grandinquisitor/chip_tunes_badge/hardware/schematic.pdf

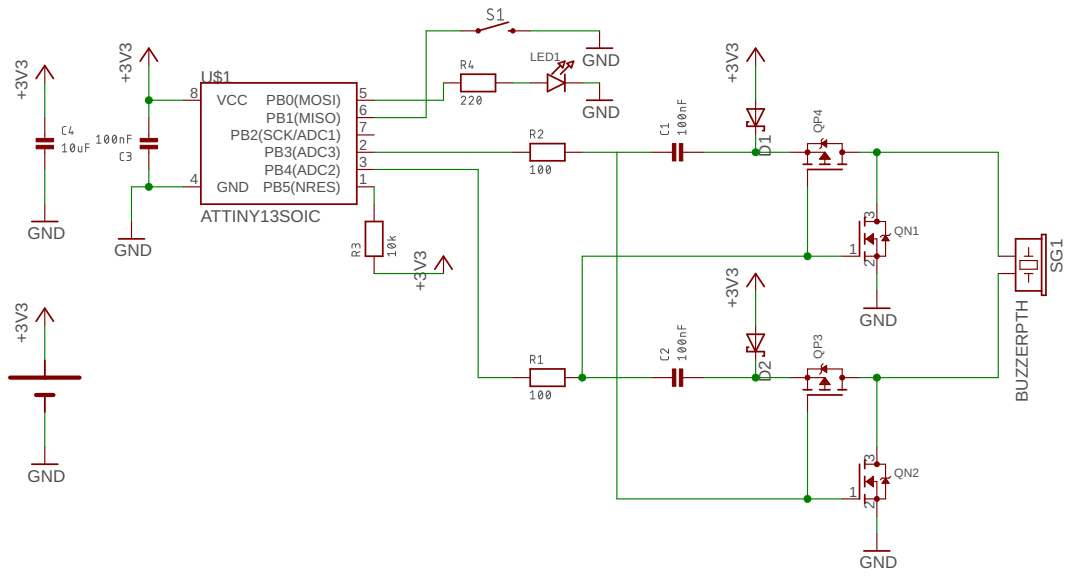
[picture p1: page 1]
