grandinquisitor/chip_tunes_badge/hardware/schematic.sch

## EAGLE design hardware/schematic.sch (2019-09-23)

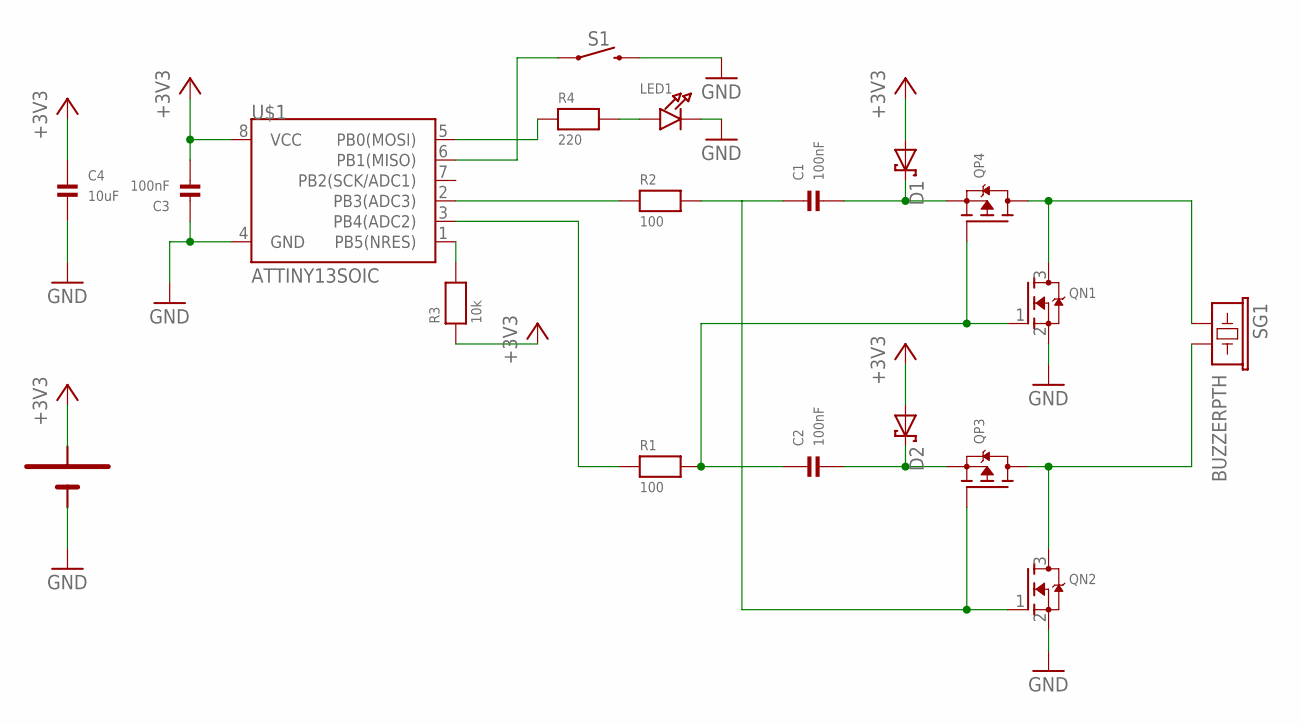
[picture p2: schematic schematic.sch]

Parts:
C1, C2, C3: 100nF; 0805
C4: 10uF; 0805
D1: SCOTTKY; SOD123F
D2: BAT20J; SOD123F
LED1: LED0805_NOOUTLINE; CHIPLED_0805_NOOUTLINE
QN1, QN2: MOSFET-NWIDE; SOT23-WIDE
QP3, QP4: MOSFET-PWIDE; SOT23-WIDE
R1, R2: 100; 0805
R3: 10k; 0805
R4: 220; 0805
S1: MOMENTARY-SWITCH-SPST-SMD-5.2MM; TACTILE_SWITCH_SMD_5.2MM
SG1: BUZZERPTH; BUZZER-12MM
U$1: ATTINY13SOIC; SO08
U$2: CR2032; COIN

Connections:
+3V3: C3.2, C4.1, D1.2 (A), D2.2 (A), R3.1, U$1.8 (VCC), U$2.+
GND: C3.1, C4.2, LED1.C, QN1.2 (S), QN2.2 (S), S1.3 (2), U$1.4 (GND), U$2.-
unnamed: R2.1, U$1.2 (PB3(ADC3))
unnamed: R1.1, U$1.3 (PB4(ADC2))
unnamed: C1.1, QN2.1 (G), QP3.1 (G), R2.2
unnamed: C2.1, QN1.1 (G), QP4.1 (G), R1.2
unnamed: C1.2, D1.1 (K), QP4.2 (S)
unnamed: QN1.3 (D), QP4.3 (D), SG1.+ (1)
unnamed: QN2.3 (D), QP3.3 (D), SG1.- (2)
unnamed: C2.2, D2.1 (K), QP3.2 (S)
unnamed: R3.2, U$1.1 (PB5(NRES))
unnamed: R4.1, U$1.5 (PB0(MOSI))
unnamed: LED1.A, R4.2
unnamed: S1.1, U$1.6 (PB1(MISO))
